SeedLabs-it/smartknob-hardware/cad/mount_base_v58-rc1.stl

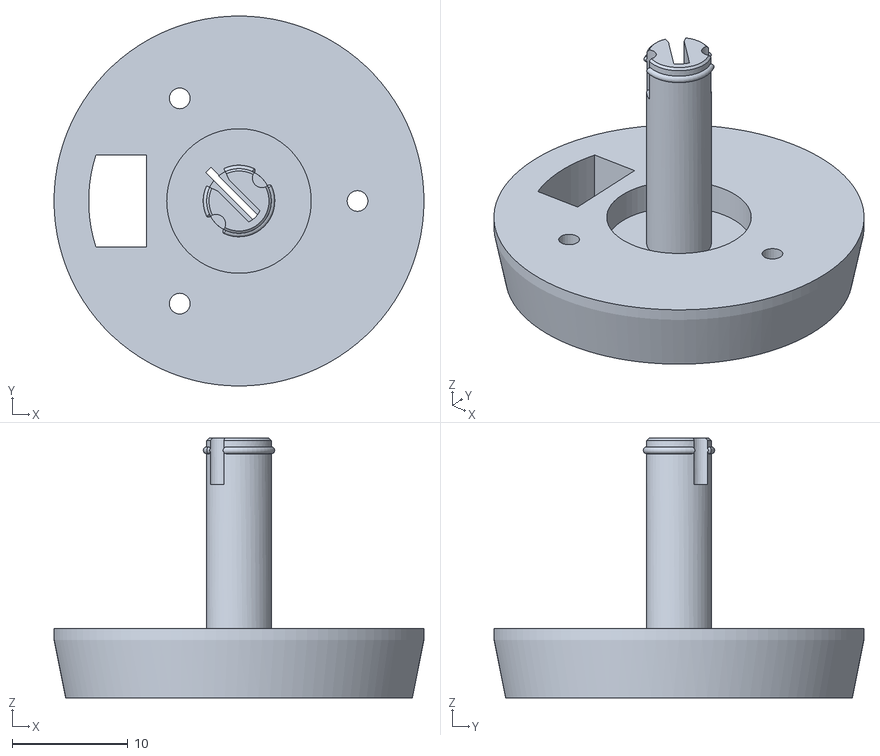
[picture p1: CAD file, 2024-03-15]
cad/mount_base_v58-rc1.stl
32.0 x 32.0 x 22.5
