SeedLabs-it/smartknob-hardware/cad/tooling/screen mounting jig.step

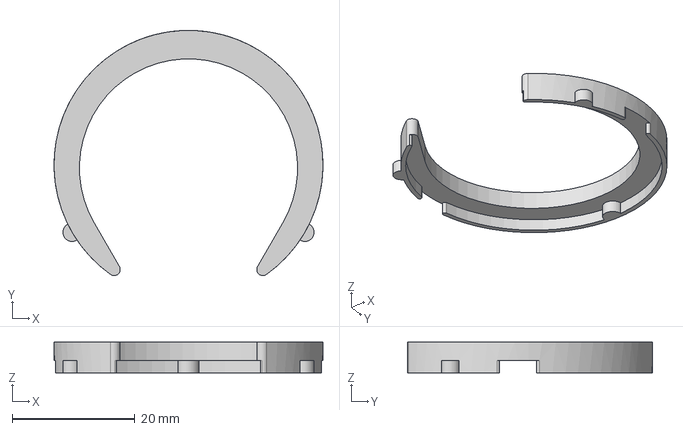
[picture p2: CAD file, 2024-06-05]
cad/tooling/screen mounting jig.step
43.9 x 40.0 x 5.00 mm
