SeedLabs-it/smartknob-hardware/cad/screen_platform_v58-rc1.stl

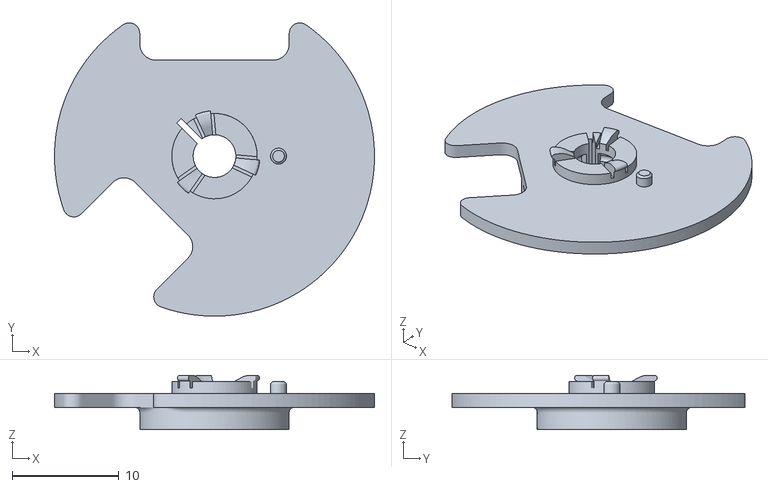
[picture p3: CAD file, 2024-03-15]
cad/screen_platform_v58-rc1.stl
30.0 x 27.5 x 5.10
