SeedLabs-it/smartknob-hardware/cad/knob_shell_v57.stl

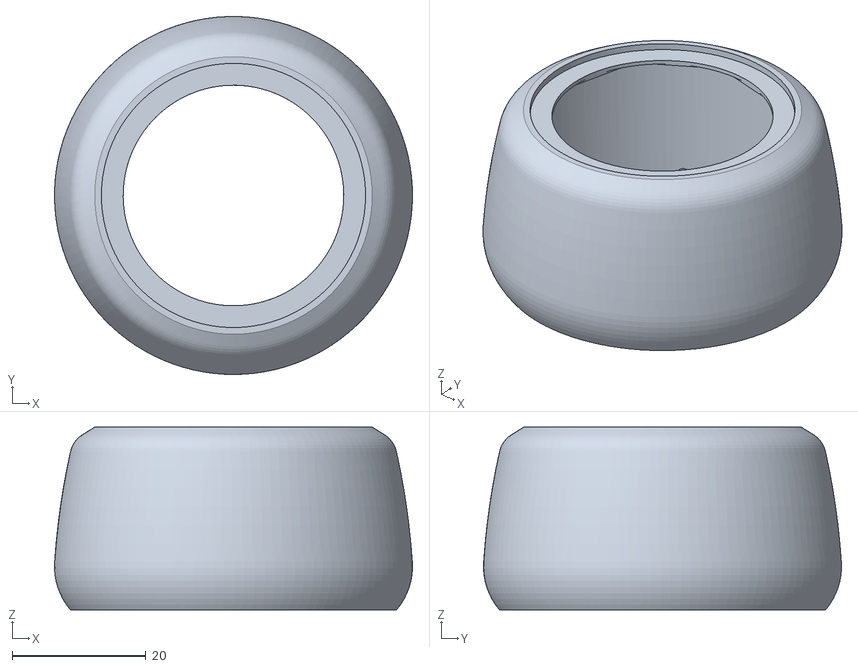
[picture p4: CAD file, 2024-03-15]
cad/knob_shell_v57.stl
53.6 x 53.6 x 27.3
