SeedLabs-it/smartknob-hardware/cad/back_plate_v49.stl

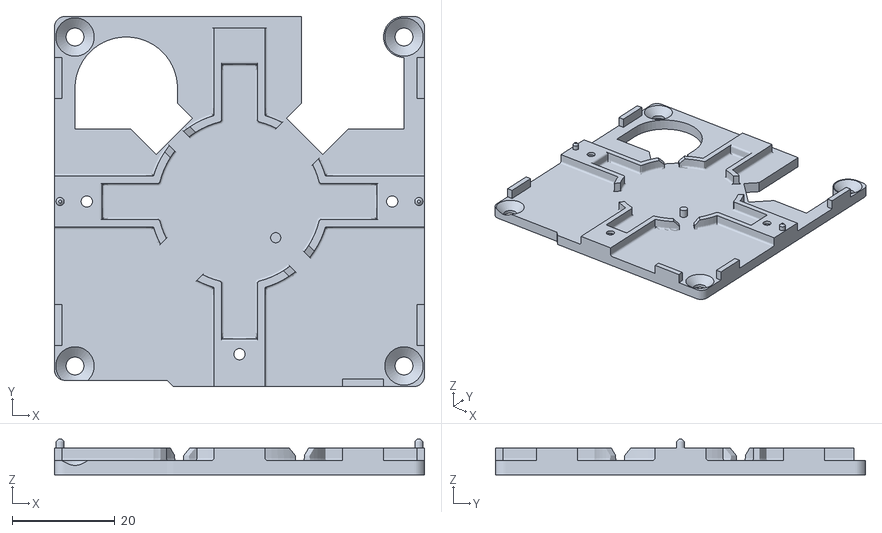
[picture p5: CAD file, 2024-02-03]
cad/back_plate_v49.stl
72.2 x 72.2 x 7.00
