SeedLabs-it/smartknob-hardware/cad/screen_platform_v45-rc2.stl

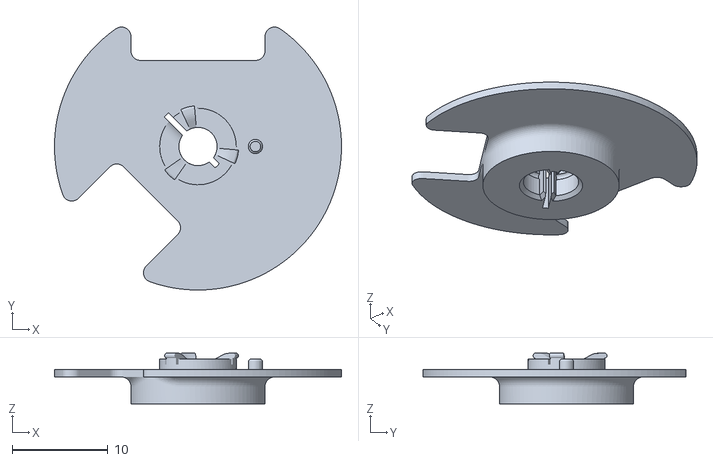
[picture p6: CAD file, 2024-01-30]
cad/screen_platform_v45-rc2.stl
30.0 x 27.5 x 5.30
