SeedLabs-it/smartknob-hardware/cad/front_panel_v81.3mf

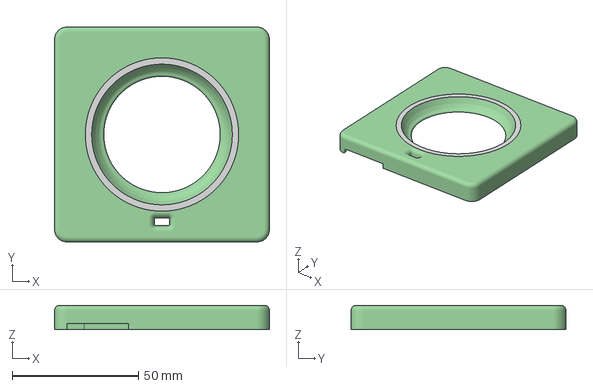
[picture p7: CAD file, 2024-01-27]
cad/front_panel_v81.3mf
85.0 x 85.0 x 9.60 mm
