SeedLabs-it/smartknob-hardware/cad/motor_spacer_v11.stl

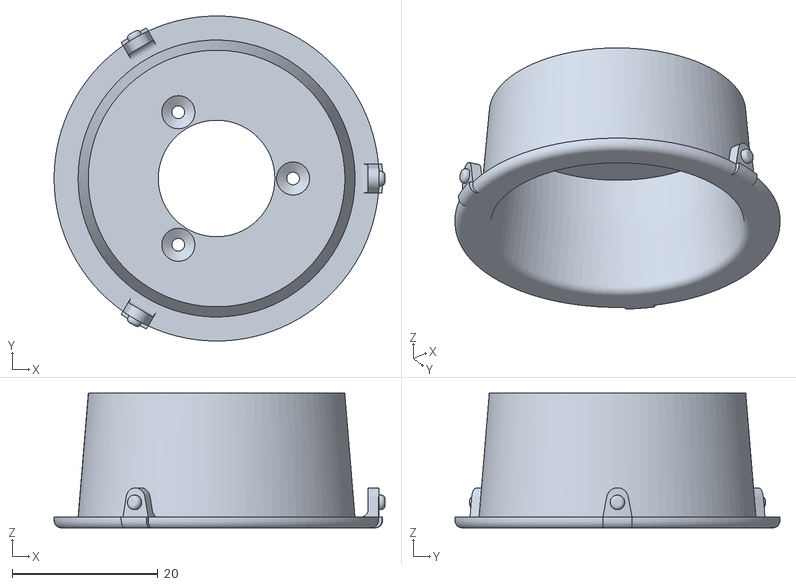
[picture p8: CAD file, 2024-01-20]
cad/motor_spacer_v11.stl
45.4 x 44.6 x 18.5
