SeedLabs-it/smartknob-hardware/(list of files, cad)

Other CAD files:
cad/screen_platform_v47_improved.stl
cad/mount_base_v45-rc2.stl
cad/tooling/screen mounting jig.stl
