SeedLabs-it/smartknob-hardware/(threads)

Thread 4 (2024-05-29):

Part numbers on schematic need updating

rdpeake, 2024-05-29:
In order to get PCBA processed (via jlcpcb) the output of kicad uses the schematic names which has the following discrepencies:

Base:
| current | working part number|
|----|----|
| MT6701-CT | MT6701CT-STD |
| VL53L0CXV0DH_1 | VL53L0CXV0DH |

screen
| current | working part number |
|----|----|
| LCD-FPC | 59453-081110EDHLF |
