SeedLabs-it/smartknob-hardware/(commit log)

2024-01-14 Minor fiexs in routing
    [view_base.kicad_pcb]
2024-01-20 added parts that should be printed at JLC
    [MountBase_v36.stl, ScreenPlatform_v36.stl, knob v11.stl]
2024-01-22 Cleaned up base PCB
    [view_base.kicad_pcb, view_base.kicad_sch]
2024-01-23 Update view_base.kicad_sch to ESP32-S3-1U-N16R8
    Changed ESP32-S3 in schematics to ESP32-S3-1U-N16R8
    [view_base.kicad_sch]
2024-01-26 Updated 3D models for 3D printing
    [Back_plate_v41.stl, Front_panel_v77-rc.3mf, Knob_shell_v43-rc.stl, Knob_shell_v43-rc_supports.stl, Motor_spacer_v11.stl, Mount_base_v36.stl, Screen_platform_v36.stl]
2024-01-27 Locked front panel design
    [Front+panel_v81.3mf, Front_panel_v77-rc.3mf]
2024-01-29 Updated sk6805 footprint
    [view_base.kicad_pcb, view_base.kicad_sch]
2024-01-30 Updated part numbers
    [view_base.kicad_pcb, view_base.kicad_sch]
2024-01-30 Updated esp32 to n16r8-u
    [view_base.kicad_pcb, view_base.kicad_sch]
2024-01-30 Prepared new shaft and screen platform
    [MountBase_v45-rc1.stl, MountBase_v45-rc2.stl, Mount_base_v36.stl, ScreenPlatform_v45-rc1.stl, ScreenPlatform_v5-rc2.stl, Screen_platform_v36.stl]
2024-01-31 fixed most of the bugs with JLC PCBA
    [view_base.kicad_pcb, view_base.kicad_sch]
2024-01-31 Updated positioning for a few last parts
    [view_base.kicad_pcb, view_base.kicad_sch]
2024-02-02 Updated USB-C footprint with correct F.Paste
    [view_base.kicad_pcb]
2024-02-03 updated models to print without supports
    [Back_plate_v41.stl, Knob_shell_v43-rc.stl, Knob_shell_v43-rc_supports.stl, back_plate_v49.stl, knob_shell_v49.stl, mount_base_v45-rc1.stl, mount_base_v45-rc2.stl, pront_panel_v81.3mf]
2024-02-28 Added 2 new version for the shaft and screen platform
    [mount_base_v56-rc1.stl, screen_platform_v56-rc1.stl]
2024-03-05 added knob shell with +0.5mm to height
    [knob_shell_v56+0.5mm.stl]
2024-03-07 updated screen pcb for PCBA
    [view_screen.kicad_pcb, view_screen.kicad_sch]
2024-03-07 fixed outline of the screen pcb
    [view_screen.kicad_pcb]
2024-03-15 updated cad
    [knob_shell_v57+0.5mm-rc1.stl, mount_base_v45-rc1.stl, screen_platform_v45-rc1.stl, screen_platform_v47_improved.stl, screen_platform_v56-rc1_with_supports.stl]
2024-03-15 updated cad models
    [screen_platform_v56-rc1.stl, screen_platform_v56-rc1_with_supports.stl, screen_platform_v58-rc1.stl]
2024-03-15 updated cad once again
    [mount_base_v56-rc1.stl, mount_base_v58-rc1.stl]
2024-04-30 split schematics in 2 parts
    [view_base.kicad_sch]
2024-05-13 Cleaned up electronics
    [knob_shell_v49.stl, knob_shell_v56+0.5mm.stl, knob_shell_v57.stl, view_base.kicad_pcb, view_base.kicad_sch, view_screen.kicad_pcb, view_screen.kicad_sch]
2024-06-05 added screen mounting jig
    [screen mounting jig.step, screen mounting jig.stl]
